limaotaizi/pynq-z2-multimodal-attention/board/DEMO_VIDEO.md

# 演示视频：分镜与录制脚本

> 目标：3 分钟以内，**一镜到底**最好，两段拼接也可以。评委要看的是「这块板真的在算、
> 算出来的东西真的是对的」，不是剪辑。所以每个镜头里出现的数字都要能在仓库档案里找到对应行。
>
> 录制日期建议：不晚于 **2026-11-03**，给上传留一天余量。

---

## 0. 录制前的一次性准备（录之前做掉，不要录进画面）

```powershell
# 1. 板子已按 board/README.md 烧好 BOOT.BIN（SD 卡启动跳线），串口线插好
powershell -ExecutionPolicy Bypass -File board\baremetal\bm_ports.ps1
$env:BM_PORT = 'COM?'          # 换成 bm_ports.ps1 报出来的那个，别用蓝牙虚拟口

# 2. 先用一次冷启动确认板子活着（这一遍不用录）
powershell -ExecutionPolicy Bypass -File board\baremetal\bm_capture_cold.ps1 -Seconds 45
```

准备清单：

- [ ] 屏幕上只留三个窗口：串口终端（放最大）、`board\baremetal\logs\` 文件夹、一个投影/PPT 窗口（可选）
- [ ] 串口终端字号调到 **画面里能看清 20.790 这个数**（这是全片最重要的一帧）
- [ ] 关掉通知弹窗、关掉微信
- [ ] 手机/相机固定，横屏 1080p，别手持
- [ ] 桌面背景换成纯色（录出来的字更清楚）

---

## 1. 分镜表

| # | 时长 | 画面 | 你要做的事 | 台词（照着念，不必逐字） |
|---|---|---|---|---|
| 1 | 0:00–0:15 | 桌面 + 板子入画 | 镜头从桌上的 PYNQ-Z2 拉起来，指着板子 | 「这是 PYNQ-Z2，XC7Z020。上面跑的是一套四模态生理信号的时间对齐与注意力推理系统，全部在 PL 里算。」 |
| 2 | 0:15–0:35 | 终端：一条命令 | 敲 `bm_capture_cold.ps1`，然后**拔掉 micro-USB** | 「为了让结果可信，我从断电开始录。这条命令在等串口消失——消失说明板子真断电了。」 |
| 3 | 0:35–0:55 | 终端：phase 2 | 看到 `phase 2 waiting for COM` 后**插回去**，然后合上电闸/按复位 | 「现在上电。它不会跑 Linux，直接进裸机程序，PS 里没有任何操作系统。」 |
| 4 | 0:55–1:20 | 终端：启动横幅 + 第一次 `r` | 等横幅滚完，看到 `28 arrays => ALL PASS` | 「一次窗口：1636 个字载入、引擎跑完、5504 个字逐位比对。28 个数组全对。」 |
| 5 | **1:20–1:35** | **终端：计时那四行** | **停在这里不要动，让镜头看清** | 「引擎本身 2079000 个周期，100 MHz 下 20.790 ms。整个窗口含载入、读回和分类头 21.645 ms。」 |
| 6 | 1:35–2:05 | 终端：`t` 序列 | 敲 `t` 或跑 `bm_repeat.ps1 -NumRounds 3 -Timing 50` | 「重复 3 轮逐位比对、50 次计时，都是同一个数。软件模型和硬件的差是 0。」 |
| 7 | 2:05–2:30 | 文本：A9 7.470 / PL 20.790 | 切到一张只有三行的对照 | 「同板 CPU 基线：A9 7.470 ms，PL 20.790 ms，**CPU 更快**。我们把这个负结果留在报告里。」（措辞见下方 §3.1） |
| 8 | 2:30–2:50 | 终端：`bm_repeat.ps1` 结束 + `repeat.json` | 打开 `board\repeat.json` 滚到最后 | 「这三个数写进了 repeat.json，和报告、metrics.csv 里的是同一个来源。」 |
| 9 | 2:50–3:00 | 桌面 | 收镜头 | 「代码、位流、仿真、上板结论，仓库里都有，每条结论后面跟着 md5。」 |

---

## 2. 一键录制命令（第二遍用这个，比手敲稳）

```powershell
$env:BM_PORT = 'COM7'

# 全片主体：3 轮逐位 + 50 次计时，最后自动写 repeat.json
powershell -ExecutionPolicy Bypass -File board\baremetal\bm_repeat.ps1 -NumRounds 3 -Timing 50
```

跑完会得到：

```
board\baremetal\logs\bm_repeat_<时间戳>.txt    原始串口全文（录屏里出现的每一行都在这里）
board\repeat.json                             解析后的结果 + 计时统计
```

这两个文件**不要改**，录完直接随提交一起上传；它们是「视频里说的数是真的」的凭据。

---

## 3. 两个必须讲清楚、不能含糊的地方

### 3.1 速度对比的方向（这一条最容易说反）

`metrics/cpu_baseline.csv` 里，同一块板、同一条 492 字指令流、同一份数据：

- Cortex-A9 @650 MHz：**7.470 ms**
- PL @100 MHz：**20.790 ms**

所以 **CPU 比 PL 快 2.78×**。PL 每拍干的活是 A9 的 2.33 倍，但时钟低 6.5 倍，净输。
视频里**绝对不要**说「PL 比 CPU 快 2.78 倍」——那是把方向说反了，而且评委一问就穿。

正确说法：

> 「我们还做了同板 CPU 基线：同样的指令流，A9 上 7.470 ms，PL 上 20.790 ms，
> **CPU 反而快 2.78 倍**。PL 每拍效率高 2.33 倍，但跑在 100 MHz，输在时钟上。
> 这条基线告诉我们瓶颈是累加器链和每拍 MAC 数，不是 DSP 不够。
> 报告 §5.4 把这个负结果原样写进去了。」

主动说出这个负结果，比藏起来强得多——它证明作者真的测过、没有编数。

如果时间紧，**就跳过这一镜**。少一镜不会扣分，说反一个数会。

### 3.2 准确率（这一条不要说高）

准确率 0.34–0.40，三类 chance 是 33.3%。**不要**在视频里说「识别情绪」。
正确说法：「它实时输出一个三分类预测；在留出被试上的准确率接近随机，
我们把它当作**平台能力演示**，不当作识别结果。」——这句话说出来比任何数字都加分。

---

## 4. 不录的东西

| 不要录 | 原因 |
|---|---|
| Vivado 综合/实现全过程 | 十几分钟，没有信息量；可复现性用 `BITSTREAM_MANIFEST.md` 证明，不用录屏 |
| 功耗仪 | 没有功耗仪。**不要**拍一个万用表假装测过 |
| 真实传感器接线 | 四路都是 AFFEC 回放，录到空的 BNC 口会立刻露馅 |
| 相机拍摄屏幕时的手抖特写 | —— |

---

## 5. 录完之后

1. 把 `demo.mp4` 放到提交包根目录（和 `checklist.md` 同级）。
2. 在 `checklist.md` 的 E3 行把「待录」改成文件名 + 时长。
3. 视频里出现的每一个数字，检查一遍能不能在 `metrics/metrics.csv` 或
   `board/baremetal/logs/` 里找到同一行。找不到的，从视频里删掉。
