limaotaizi/pynq-z2-multimodal-attention/checklist.md

# 提交自检清单

> 对照 2026 全国大学生嵌入式芯片与系统设计竞赛 · FPGA 创新设计赛道 · 自主选题
> 的提交要求逐项打勾。**未完成项也列在最下面**——评委会看到的东西，作者先看一遍。
>
> 提交截止：**2026-11-04 18:00**。本清单最后一次核对：**2026-10-29**。

---

## A. 硬性要求

| # | 要求 | 状态 | 位置 / 说明 |
|---|---|---|---|
| A1 | 报名已完成（否则后续全部归零） | ✅ **2026-10-29 作者确认** | 本清单无法自证，只能由作者登录官网核对；组别与提交账号已由作者确认无误 |
| A2 | 仓库内所有目录名/文件名英文 | ✅ | `find . -name "*[^ -~]*"` 无输出；中文只出现在 `.md`/`.csv` 正文与注释里 |
| A3 | 开源许可 MIT 或 Apache-2.0 | ✅ | `LICENSE`（MIT，代码）、`DATA_LICENSE.md`（数据：AFFEC 原始数据不分发，只放派生测试向量）、`THIRD_PARTY.md`（第三方工具/包/数据的许可与分发状态，逐项列明） |
| A4 | 提交仓库在 GitHub/Gitee 开源 | ✅ **2026-10-29 已推送** | https://github.com/limaotaizi/pynq-z2-multimodal-attention（公开，`main`，MIT）；提交身份用 GitHub noreply 邮箱，未暴露真实地址 |
| A5 | 工具版本说明 | ✅ | 全流程 Vivado/Vitis **2024.1**；指南推荐 2025.2/2026.1，差距与「未在新版本上验证过」写在 `build/README.md` 末尾与报告 §4 |

## B. 交付物（指南 3.3.5）

| # | 要求 | 状态 | 位置 | 怎么验 |
|---|---|---|---|---|
| B1 | 完整工程源码 | ✅ | `src/rtl`（17 个 `.v`）、`src/model`（10 个 `.py`） | `ls src/rtl src/model` |
| B2 | 仿真/验证结果 | ✅ | `sim/`（8 个 tb、三档金标准向量、一条命令跑通） | `cd sim/run && ./run_attn_m4.sh` → 28 数组 5,504 字 ALL PASS |
| B3 | 综合实现报告（资源/时钟/关键性能） | ✅ | `build/reports/*.rpt`、`metrics/resource.csv`、`metrics/timing.csv` | 报告与实际 `report_utilization` 逐行一致（2026-10-29 重建验证过） |
| B4 | 上板脚本 + 实测 + 参考比对 | ✅ | `board/`（串口/裸机/部署三组脚本 + `logs/`）、`metrics/latency.csv`、`metrics/cpu_baseline.csv` | `board/README.md`；三次重复 × 28 数组 × 5,504 字全 PASS |
| B5 | 可复现构建脚本 | ✅ **2026-10-29 三档全部验证** | `build/make_tree.ps1` + `build/*.tcl` + `build/README.md` | 只用仓库文件重建：M=4 与 M=2 的位流与已发货版逐字节相同（仅 `.bit` 头部构建时间戳不同，抹掉后 md5 相等）；M=3 复现交付设计的全部报告数字，但位流有 57 字节配置数据不同——判定为同一设计的不同布线解，证据与出处缺口写在 `BITSTREAM_MANIFEST.md` §Rebuild verification 的 M=3 小节 |
| B6 | `skill/` 技能包 | ✅（离线） | `skill/`（`pynq_probe`、`golden_compare.py`、`regmap.json`、50 项离线测试） | `sh skill/tests/run_tests.sh`；**板上模块未在硬件上验证，已声明** |
| B7 | 设计报告（含大模型协作与失败分析） | ✅ | `report/design_report.pdf`（源 `design_report.md`）、`report/ai_collab.pdf` | `python report/make_pdf.py` 重建 |
| B8 | 大模型协作记录 | ✅ | `report/ai_collab.md` / `.pdf` | 提示词、纠错轨迹、可复用经验 |

## C. 评分项对照（自主选题 3.3.5.5，满分 100）

| 评测项 | 权重 | 本作品的证据 | 自我评估 |
|---|---:|---|---|
| 创新性与应用价值 | 30 | 确定性多模态时间对齐 + 可复现的低延迟推理平台；10 ns 时间戳量化 | 平台/方法分拿得到，「产品闭环」分拿不到——**无真实传感器接入** |
| 性能与资源优化效果 | 20 | 20.790 ms / 窗 @100 MHz；同板 A9 CPU 基线 **7.470 ms ⇒ A9 快 2.78×**；6,995 LUT / 44 BRAM / 20 DSP | **这一项是负的**：同板基线证明当前 PL 实现比 CPU 慢。能拿的是资源约束（44/140 BRAM、20 DSP）与延迟可预测性，不是加速比 |
| 功能正确性与设计完整性 | 20 | 三档规模逐位一致（14/21/28 数组），仿真 + 板上 + 裸机三条独立路径 | 强 |
| 大模型协作与技能包 | 15 | `report/ai_collab.pdf` 5 页 + `skill/` 离线 50 项测试 | 记录完整；技能包板上部分未实测 |
| 文档质量与可复现性 | 15 | 报告 17 页七节齐全、`metrics/metrics.csv` 一数一源、`evidence_manifest.json` 逐条 md5、构建可复现 | 强，本轮重点补的就是这块 |

## D. 本轮（2026-10-29）补上的

| 项 | 变化 |
|---|---|
| 同板 CPU 基线 | 新增 `board/baseline/`，A9 执行同一条 492 字指令流，22/22 块逐位一致。**结果对 PL 不利**：A9 7.470 ms vs PL 20.790 ms = A9 快 2.78×（报告 §5.4 已按此改写） |
| 位流可复现 | 新增 `build/make_tree.ps1` + `write_bit_attn{2,3}.tcl`；M=2/M=4 位流逐字节复现，M=3 复现交付设计的全部报告数字（位流有 57 字节布线差异，已如实记录） |
| 地址映射 | `build_bd_all.tcl` 现在**固定并回读**三个从机地址；此前新工程会把它自动分配到 `0x4001_1000`，与 `main.c` 的编译期断言冲突 |
| 证据链 | 新增 `evidence_manifest.json`（每条结论 → 文件 → md5）与 `metrics/make_evidence_manifest.py` |
| 板端复验 | 板上重跑 3/3 轮 ALL PASS，中位 21.644 ms |

## E. 上传状态（2026-10-29）

| # | 事项 | 状态 |
|---|---|---|
| E1 | 提交身份与首次 commit | ✅ `user.name = limaotaizi`，邮箱为 GitHub noreply 地址，未暴露真实邮箱；`07cc54e`，284 文件 |
| E2 | 建远端仓库并推送 | ✅ https://github.com/limaotaizi/pynq-z2-multimodal-attention（`main`，公开） |
| E3 | 演示视频 `demo.mp4`（上电 → 串口 → 逐位 PASS → 计时） | **待录制**——分镜与录制脚本见 `board/DEMO_VIDEO.md` |

## F. 明确没做（不填数、不淡化）

| 项 | 状态 | 为什么 |
|---|---|---|
| 功耗实测（S0/S1/S2/S3） | **未测量** | 无功率计，板载无 PMBus。**不用资源反推** |
| 真实传感器接入 | **未接入** | 四路信号均为 AFFEC 回放，`SRC=0xF` 内部节拍 |
| 四路外部同步误差 | **未测量** | 需同步台架 + 示波器/逻辑分析仪；10 ns 只修饰「时间戳量化」 |
| Vivado 2025.2 / 2026.1 复测或重建 | **未做** | 本机只装 2024.1。构建脚本通过环境变量解析工具路径，但没在新版本上跑过 |
| `skill/` 板上模块 | **未在硬件验证** | 已声明；离线 50 项测试全过 |

---

## 一句话

工程证据是硬的，提交物是软的——本轮把「软」的部分补齐了大部分：可复现构建从承诺变成了
逐字节证据，同板 CPU 基线补上了性能分母，证据链细化到每个文件的 md5。报名已于
2026-10-29 由作者确认，仓库已于同日推送至 GitHub。只剩演示视频一件事。
