limaotaizi/pynq-z2-multimodal-attention/(commit log)

2026-10-29 Initial submission: deterministic multimodal time-alignment + low-latency inference on PYNQ-Z2
    Fixed-point attention engine (M=2/3/4) and a 10 ns timestamp front-end for
    four-modality physiological signals, bit-exact against the Python reference
    model and characterised down to the cycle.
    - src/rtl, src/model RTL and the model it is checked against
    - sim/ test benches plus committed golden vectors, one command per mode
    - build/ Tcl that rebuilds each mode's bitstream from the repository
    alone; M=2 and M=4 reproduce the shipped bitstreams, M=3
    reproduces their reports (see BITSTREAM_MANIFEST.md)
    - board/ bar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
2026-10-29 Add THIRD_PARTY.md; label the two latency figures for what they are
    The review document lists a third-party notice as a required deliverable and the
    repository had none. THIRD_PARTY.md separates tools that produced the artefacts
    from runtime dependencies, states that no third-party source is vendored, and
    explains the one vendor-generated file that is committed (skill/tests/data/all_bd.hwh).
    README called 21.650 ms a median; it is the sum of four measured segments from
    the bare-metal end-to-end run. The median of the 50-sample repeat is 21.644 ms
    (board/repeat.json). Report section 5.2 also quoted a p99 that the committed
    JSON does not contain - replaced with p90 and max, which it does.
